sr-sebastian/urubotsrescue/cad/out/masa_cg.md

# Presupuesto de masa y centro de gravedad

_Archivo generado por `cad/build.py`: no editar a mano._

**Masa total estimada: 16.50 kg**  
**CG (base_footprint): x = 29 mm, y = 1 mm, z = 113 mm**

| Código | Pieza | Cant. | g/u | g total |
|---|---|---:|---:|---:|
| REF-M1 | Motorreductor 775 24V planetario 42mm (tracción) | 2 | 750 | 1500 |
| CH-01 | Placa lateral | 2 | 741 | 1482 |
| REF-BAT | Batería 6S Li-ion 21700 6S2P (≈10 Ah) | 1 | 1300 | 1300 |
| — | Bulonería, rodamientos, escuadras | 1 | 1100 | 1100 |
| — | Cableado y conectores | 1 | 900 | 900 |
| CH-03 | Piso | 1 | 777 | 777 |
| REF-M2 | Motorreductor 775 24V planetario 56mm 1:264 (flipper) | 1 | 750 | 750 |
| CH-04 | Deck superior | 1 | 541 | 541 |
| DT-02 | Polea delantera compuesta 60T+60T | 2 | 249 | 498 |
| FL-01 | Brazo de flipper | 2 | 226 | 451 |
| CH-02 | Placa exterior de oruga | 2 | 225 | 451 |
| REF-SV | Servo Feetech STS3215 12 V (x7) | 7 | 55 | 385 |
| REF-S2 | Tubo de flipper Al 6061 20x2 x 400 | 1 | 348 | 348 |
| REF-DEP | Cámara de profundidad (Orbbec Gemini 2 / RealSense D435i) | 1 | 300 | 300 |
| REF-jetson | Jetson Orin Nano Super (devkit) | 1 | 280 | 280 |
| CH-06 | Mamparo trasero (panel de conectores) | 1 | 270 | 270 |
| CH-05 | Mamparo delantero | 1 | 268 | 268 |
| REF-LID | Livox Mid-360 (LiDAR 3D) | 1 | 265 | 265 |
| REF-B1 | Correa HTD 1100-5M-25 (oruga) | 2 | 131 | 262 |
| — | Cámaras USB (x3) + parlante + micrófono | 1 | 250 | 250 |
| CH-07 | Escuadra Al 20x20x2 | 4 | 62 | 246 |
| DT-01 | Polea motriz trasera 60T HTD5M | 2 | 122 | 244 |
| FL-02 | Cubo de flipper | 2 | 115 | 230 |
| REF-B2 | Tacos montados (oruga principal) | 2 | 92 | 184 |
| REF-B3 | Correa HTD 760-5M-25 (flipper) | 2 | 91 | 182 |
| REF-S1 | Eje motriz acero 12 mm (largo según params) | 2 | 83 | 165 |
| DT-03 | Rodillo de apoyo ø40 | 6 | 22 | 130 |
| REF-B4 | Tacos montados (flipper) | 2 | 64 | 128 |
| AR-02 | Torreta + mejillas del hombro | 1 | 122 | 122 |
| REF-buck_12v_pc | Buck 24->12 V 10 A (Jetson) | 1 | 120 | 120 |
| REF-buck_12v_arm | Buck 24->12 V 10 A (servos brazo) | 1 | 120 | 120 |
| REF-drv_traccion | Cytron MDD20A (tracción, 2 canales) | 1 | 120 | 120 |
| REF-hub_usb | Hub USB 3.0 alimentado 7 puertos | 1 | 120 | 120 |
| DT-08 | Soporte motor de tracción (tensable) | 2 | 59 | 118 |
| MT-01 | Bandeja de electrónica | 1 | 115 | 115 |
| AR-04 | Codo inferior + servo J3 | 1 | 110 | 110 |
| REF-rele_estop | Contactor/relé 40 A del E-stop | 1 | 100 | 100 |
| AR-01 | Base del brazo | 1 | 100 | 100 |
| CH-09 | Asa de transporte | 2 | 50 | 99 |
| DT-04 | Polea punta de flipper 36T | 2 | 49 | 98 |
| DT-11 | Soporte motor de flipper | 1 | 88 | 88 |
| REF-ESTOP | E-stop hongo 22 mm NC | 1 | 80 | 80 |
| REF-drv_flipper | Cytron MDD10A (flipper + canal libre) | 1 | 80 | 80 |
| REF-fusibles | Caja fusibles ATO 6 vías | 1 | 80 | 80 |
| MT-04 | Cabezal de sensores frontal | 1 | 73 | 73 |
| CH-08 | Separador placa lateral-exterior | 8 | 9 | 72 |
| MT-03 | Mástil del LiDAR | 1 | 63 | 63 |
| REF-F1 | Eje de punta M10 | 2 | 31 | 62 |
| REF-THM | Cámara térmica USB 256x192 | 1 | 60 | 60 |
| REF-esp32 | ESP32-S3 DevKitC-1 + placa base (PCB-01) | 1 | 60 | 60 |
| MT-02 | Cuna de batería | 1 | 58 | 58 |
| AR-07 | Pinza (dedos engranados) + cámara + Hall | 1 | 56 | 56 |
| DT-07 | Polea 30T eje trasero (HTD5M 15) | 2 | 28 | 56 |
| REF-buck_5v | Buck 24->5 V 5 A (lógica/USB/LEDs) | 1 | 50 | 50 |
| AR-03 | Cubo del hombro (2x GT2 40T) | 1 | 47 | 47 |
| AR-06 | Horquilla de muñeca + servo J5 | 1 | 46 | 46 |
| AR-05b | Soporte servo muñeca J4 | 1 | 37 | 37 |
| AR-05a | Cubo del codo (GT2 40T) | 1 | 30 | 30 |
| DT-10 | Polea 30T tubo de flipper (HTD5M 15) | 1 | 27 | 27 |
| DT-06 | Polea 20T motor de tracción (HTD5M 15) | 2 | 12 | 23 |
| FL-05 | Alojamiento rodamiento 6804 | 2 | 11 | 23 |
| FL-04c | Soporte sensor de ángulo | 1 | 19 | 19 |
| MT-06 | Soporte cámara frontal | 1 | 19 | 19 |
| AR-08 | Tubo eslabón 1 (CF 20x18) | 1 | 16 | 16 |
| AR-09 | Tubo eslabón 2 (CF 20x18) | 1 | 14 | 14 |
| DT-09 | Polea 14T motor de flipper (HTD5M 15) | 1 | 12 | 12 |
| MT-05 | Protección del E-stop | 1 | 10 | 10 |
| FL-04b | Engranaje 40T con imán (AS5600) | 1 | 8 | 8 |
| FL-04a | Engranaje 40T sensor (sobre tubo) | 1 | 6 | 6 |
| CH-10 | Separador de rodillo | 6 | 0 | 2 |

## Estabilidad estática (solo orugas, flippers sin apoyar)

- Ángulo de vuelco hacia atrás subiendo de frente: **56°** (escalera del reglamento: hasta 45°; con flippers apoyados el margen crece).
- Ángulo de vuelco lateral: **51°**.

Si cambiás posiciones de batería/electrónica en `params.py`, volvé a correr el build.
