sr-sebastian/urubotsrescue/docs/img/vista_front.png

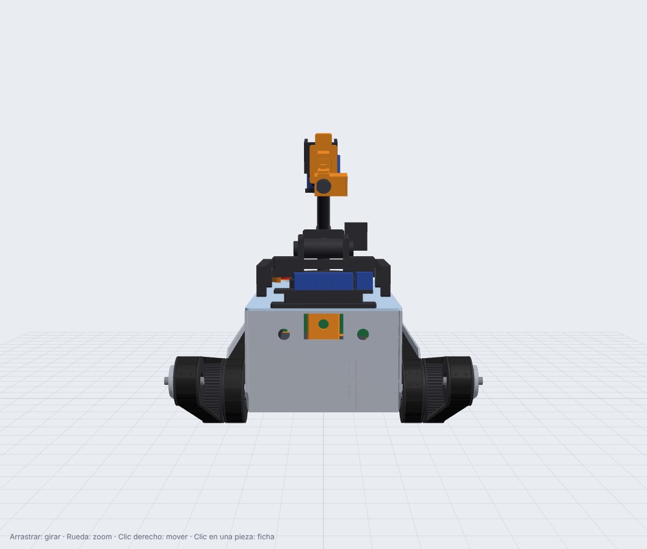
docs/img/vista_front.png
