sr-sebastian/urubotsrescue/docs/img/vista_top.png

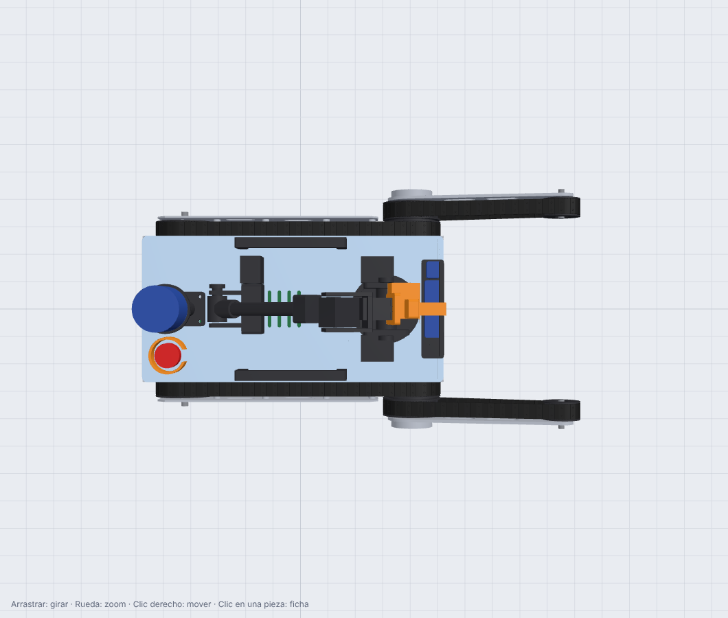
docs/img/vista_top.png
