sr-sebastian/urubotsrescue/hardware/bom.csv

subsistema | item | especificacion | cantidad | usd_unit | proveedor_sugerido | notas
computo | Jetson Orin Nano Super Developer Kit 8GB | JetPack (ver setup-jetson) | 1 | 249 | NVIDIA / distribuidor oficial | ROS 2 Jazzy + YOLO (TensorRT). Revisar al comprar si hay un modelo más nuevo al mismo precio
computo | SSD NVMe M.2 2280 256 GB | PCIe Gen3 | 1 | 30 | local | El sistema va en el NVMe (no en microSD)
computo | ESP32-S3-DevKitC-1 N8R8 | USB nativo | 2 | 15 | Espressif / AliExpress | 1 de repuesto ya flasheado
potencia | Batería 6S2P 21700 (≈10 Ah) con BMS 40 A | 22.2 V nominal / 25.2 V cargada | 3 | 120 | armado local o comercial | 1 en uso + 1 cargando + 1 de reserva
potencia | Cargador balanceador 6S ≥ 200 W | ISDT / ToolkitRC / SkyRC | 1 | 60 | AliExpress | Cargar siempre dentro de bolsa ignífuga
potencia | Bolsa ignífuga para baterías |  | 2 | 10 | AliExpress
potencia | Pulsador de parada de emergencia hongo 22 mm NC | con bloque NC+NO | 1 | 8 | local (electricidad industrial) | Reglamento: E-stop obligatorio
potencia | Relé/contactor DC 24 V 40 A (bobina 24 V) | tipo automotriz 24 V o contactor DC | 1 | 8 | local | El E-stop corta la bobina = corta motores y servos
potencia | Interruptor principal 30 A | rocker o llave rotativa | 1 | 6 | local
potencia | Portafusibles ATO 6 vías + fusibles | 40/20/15/10/5/3 A | 1 | 12 | local (automotriz)
potencia | Shunt 2 mΩ 40 A + módulo INA226 | I2C 0x40 | 1 | 10 | AliExpress
potencia | Convertidor DC-DC 24→12 V 10 A | entrada 9-36 V | 2 | 15 | AliExpress | Uno para Jetson+hub; otro para servos del brazo
potencia | Convertidor DC-DC 24→5 V 5 A |  | 1 | 8 | AliExpress | ESP32 + LEDs + sensores 5 V
potencia | Conectores XT60/XT30 + JST-XH + Dupont + GX12 | kit | 1 | 25 | AliExpress | Ver estándar de conectores en docs/04
potencia | Cable siliconado 12/16/18/22 AWG (rojo/negro) | 2 m de cada | 1 | 25 | AliExpress
motores | Motorreductor 775 24 V planetario 42 mm 1:51 con encoder Hall | ≈118 rpm, ≥4 N·m nominal, eje ≥30 mm | 2 | 45 | AliExpress | Tracción. Verificar PCD 32 mm, M4 y rpm reales del 775
motores | Motorreductor 775 24 V con reductora planetaria 56 mm 1:264 | ≈23 rpm, par nominal de la reductora ≥ 20 N·m, eje 12 mm | 1 | 70 | AliExpress | Flipper (+ correa 14T→30T)
motores | Cytron MDD20A | 2 canales, 20 A, 6-30 V | 1 | 35 | Cytron | Tracción
motores | Cytron MDD10A | 2 canales, 10 A, 5-30 V | 1 | 25 | Cytron | Flipper + canal libre
transmision | Correa HTD 1100-5M-25 | 220 dientes | 4 | 20 | proveedor de transmisiones | 2 + 2 repuesto
transmision | Correa HTD 760-5M-25 | 152 dientes | 4 | 15 | proveedor de transmisiones | 2 + 2 repuesto
transmision | Correa HTD 300-5M-15 | 60 dientes | 3 | 8 |  | tracción izquierda + flipper (+1 rep.)
transmision | Polea HTD 14-5M-15 de aluminio (bore 12 + chavetero) | motor del flipper | 2 | 10 | proveedor de transmisiones | 1 + 1 repuesto
transmision | Correa HTD 425-5M-15 | 85 dientes | 2 | 8 |  | tracción derecha (+1 rep.)
transmision | Rodamiento 6804-2RS (20x32x7) |  | 8 | 3 | local/AliExpress | 2 placas + 4 en poleas delanteras + 2 rep.
transmision | Rodamiento 6900-2RS (10x22x6) |  | 6 | 2 |  | poleas de punta de flipper
transmision | Rodamiento 608-2RS (8x22x7) |  | 12 | 1 |  | 6 rodillos + 4 brazo + 2 rep.
transmision | Rodamiento con brida KFL001 (eje 12) |  | 4 | 4 |  | eje motriz trasero
transmision | Rodamiento MR105-2RS (5x10x4) |  | 2 | 1 |  | sensor de ángulo del flipper
transmision | Eje acero plata 12 mm h7 x 1 m | + chavetas 4x4 | 1 | 15 | local (tornería)
transmision | Tubo Al 6061 20x2 x 1 m | eje de flippers | 1 | 10 | local
transmision | Bulonería (M10x60 8.8 x2; M8x60 x8; M5 y M4 surtido; M3 + insertos térmicos) | kit | 1 | 40 | local
estructura | Corte láser/agua de placas de aluminio | 5052 4 mm (CH-01 x2), 3 mm (CH-02 x2, CH-03, CH-05, CH-06), 6061 5 mm (FL-01 x2) | 1 | 150 | taller de corte local | Enviar DXF de cad/out/dxf
estructura | Policarbonato 4 mm 500x300 | deck CH-04 | 1 | 20 | local | Corte con router o sierra (NO láser CO2)
estructura | Perfil ángulo Al 20x20x2 x 2 m |  | 1 | 10 | local
estructura | Tubo Al 25x2 x 0.3 m | mástil LiDAR | 1 | 5 | local
estructura | Filamento PLA-CF (fibra de carbono) | 1 kg | 2 | 30 |  | poleas y soportes
estructura | Filamento PETG | 1 kg | 2 | 20
estructura | Filamento TPU 95A | 1 kg | 1 | 30 |  | tacos de oruga (≈210)
sensores | Livox Mid-360 | LiDAR 3D 360° + IMU | 1 | 749 | Livox / distribuidor | FAST-LIO y PLY del laberinto
sensores | Cámara de profundidad Orbbec Gemini 2 (o RealSense D435i) | RGB-D | 1 | 234 | Orbbec | Alineada al color para ubicar POIs
sensores | Cámara térmica USB 256x192 (InfiRay P2 Pro / Topdon TC001) | UVC Y16 | 1 | 250 |  | Tarea térmica (5 pts) + firma de calor del laberinto
sensores | Cámara USB 1080p gran angular (ELP o similar) | MJPG | 2 | 35 | AliExpress | frontal + trasera
sensores | Cámara USB mini (endoscopio/módulo 1080p) | para la pinza | 1 | 25 | AliExpress | inspección y QR chicos
sensores | IMU BNO055 (módulo) | I2C 0x28 | 1 | 25 | Adafruit / AliExpress
sensores | Módulo AS5600 + imán diametral | salida analógica | 2 | 4 | AliExpress
sensores | Sensor Hall lineal SS49E |  | 5 | 0.5 | AliExpress | Tarea de proximidad con imán (3 pts)
sensores | Placa de audio USB + micrófono + parlante 3 W |  | 1 | 25 | AliExpress | Audio bidireccional (2 pts)
sensores | Tira WS2812 8 LEDs + 2 focos LED 12 V 3 W + módulo MOSFET |  | 1 | 13 | AliExpress
comunicaciones | Router de viaje 5 GHz con antenas externas (GL.iNet GL-MT3000 o similar) | robot | 1 | 90 |  | Ethernet al Jetson
comunicaciones | Router/AP 5 GHz estación de operador |  | 1 | 90 |  | Mismo SSID dedicado; canal fijo
comunicaciones | Hub USB 3.0 alimentado 7 puertos | entrada 12 V | 1 | 30 |  | Cámaras y adaptadores
comunicaciones | Joystick tipo Xbox con cable |  | 2 | 40 | local | 1 de repuesto
brazo | Servo Feetech STS3215 12 V (30 kg·cm) | bus serie TTL | 8 | 18 | Feetech / AliExpress | 7 + 1 de repuesto
brazo | Adaptador de bus serie Waveshare Bus Servo Adapter (A) | USB | 1 | 8 | Waveshare
brazo | Tubo de fibra de carbono 20x18 x 1 m |  | 1 | 15 | AliExpress | eslabones
brazo | Correas GT2 6 mm cerradas (140 y ≈172 mm) + poleas GT2 20T |  | 1 | 15 | AliExpress
brazo | Rodamiento giratorio "lazy susan" 4 pulgadas |  | 1 | 5 | local
varios | Imanes de neodimio 10x3 + espuma + velcro + precintos + termocontraíble | kit | 1 | 20 | local
varios | Contingencia (≈10%) |  | 1 | 300 |  | repuestos que se rompen en la competencia
