sr-sebastian/urubotsrescue/cad/out/carpincho_ensamble.step

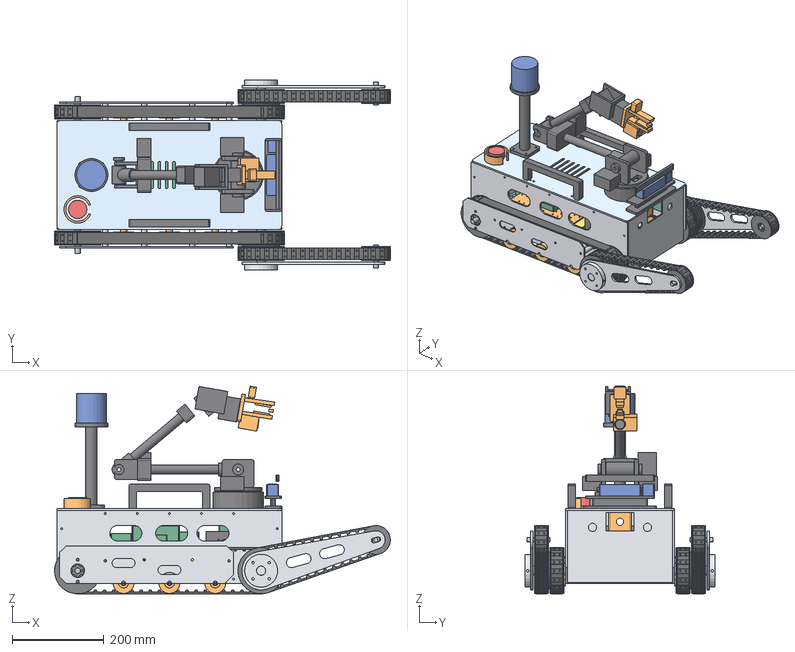
[picture p6: CAD file, 2026-10-31]
cad/out/carpincho_ensamble.step
732.8 x 414.0 x 453.1 mm
CH-01_L
CH-01_R
CH-02_L
CH-02_R
CH-03
CH-04
CH-05
CH-06
CH-07_LB
CH-07_RB
CH-07_LT
CH-07_RT
CH-08_L
CH-08_R
CH-08_L_2
CH-08_R_3
CH-08_L_4
CH-08_R_5
CH-08_L_6
CH-08_R_7
CH-09_0
CH-09_1
CH-10_L
CH-10_R
CH-10_L_2
CH-10_R_3
CH-10_L_4
CH-10_R_5
DT-01_L
DT-01_R
DT-02_L
DT-02_R
DT-03_L
DT-03_R
DT-03_L_2
DT-03_R_3
DT-03_L_4
DT-03_R_5
DT-06_L
DT-06_R
DT-07_L
DT-07_R
DT-08_L
DT-08_R
DT-09
DT-10
DT-11
REF-M1_L
REF-M1_R
REF-M2
REF-B1_L
REF-B1_R
REF-B2_L
REF-B2_R
REF-B3_L
REF-B3_R
REF-B4_L
REF-B4_R
REF-S1_L
REF-S1_R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
