sr-sebastian/urubotsrescue/cad/out/step/DT-08.step

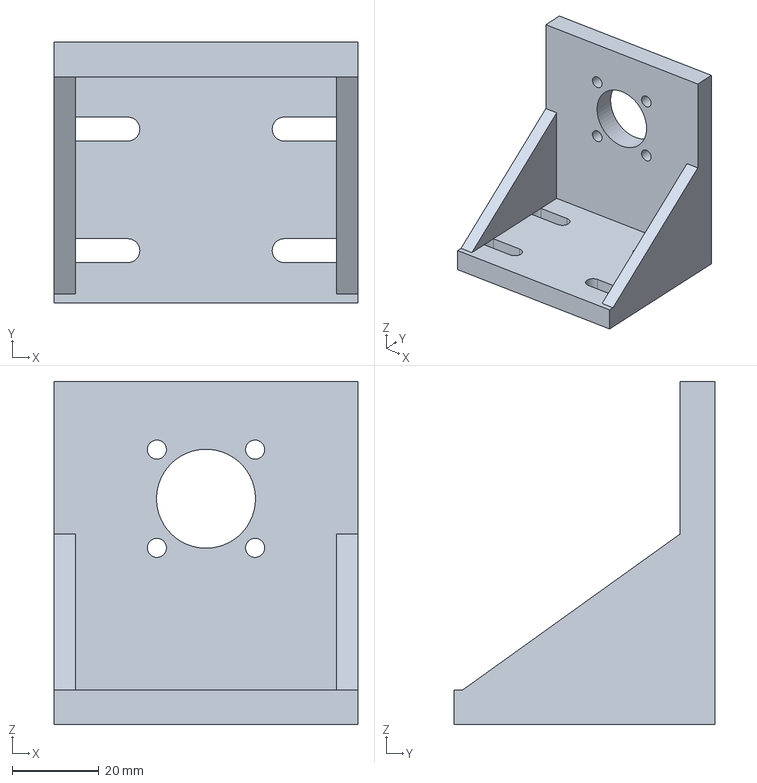
[picture p7: CAD file, 2026-10-31]
cad/out/step/DT-08.step
70.0 x 60.0 x 79.0 mm
