sr-sebastian/urubotsrescue/cad/out/step/MT-05.step

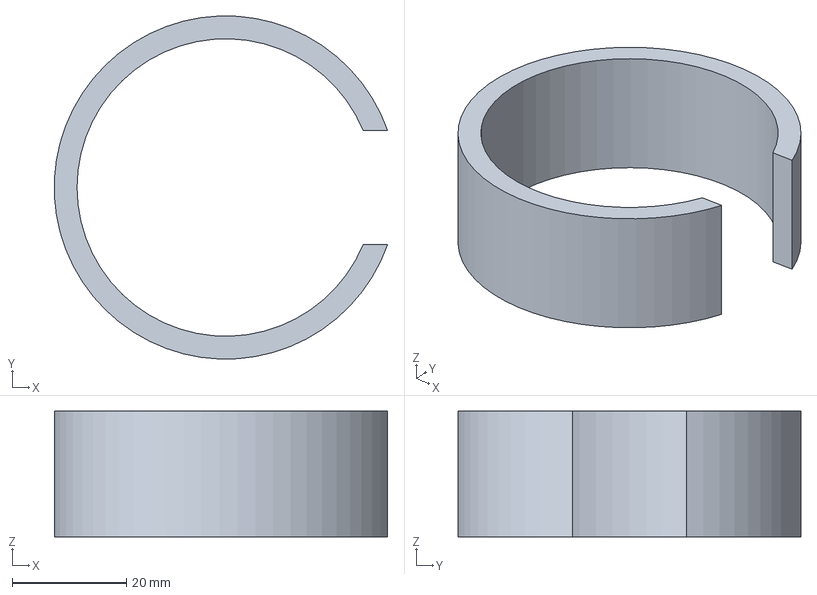
[picture p8: CAD file, 2026-10-31]
cad/out/step/MT-05.step
58.2 x 60.0 x 22.0 mm
