sr-sebastian/urubotsrescue/cad/out/step/FL-04c.step

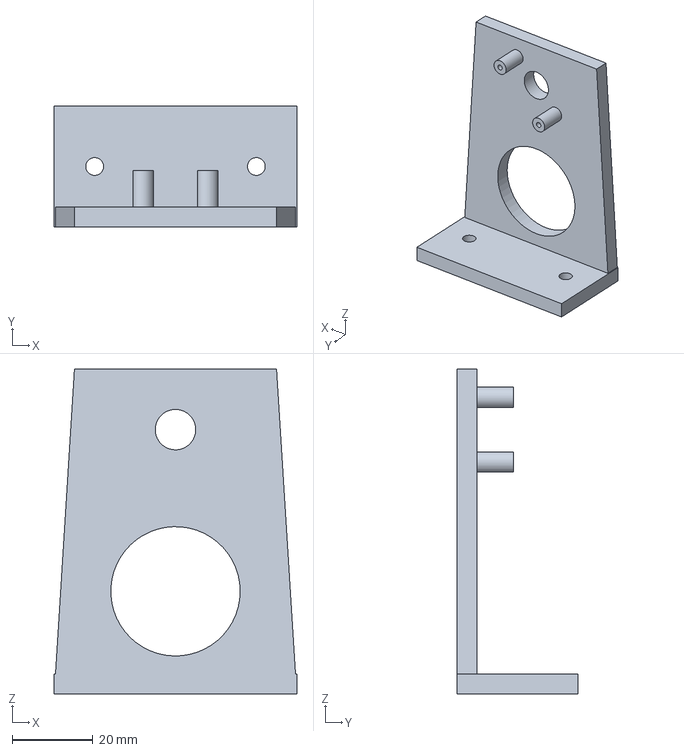
[picture p9: CAD file, 2026-10-31]
cad/out/step/FL-04c.step
60.0 x 30.0 x 80.4 mm
