sr-sebastian/urubotsrescue/cad/out/step/CH-04.step

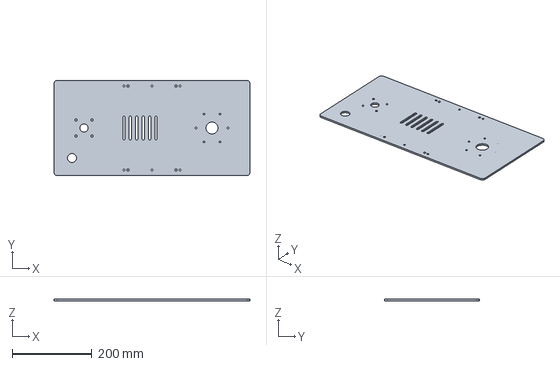
[picture p10: CAD file, 2026-10-31]
cad/out/step/CH-04.step
490.0 x 238.0 x 4.00 mm
