sr-sebastian/urubotsrescue/cad/out/step/DT-01.step

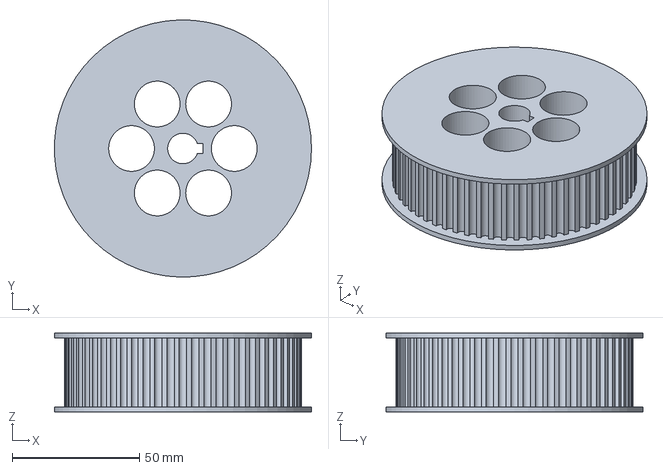
[picture p11: CAD file, 2026-10-31]
cad/out/step/DT-01.step
101.1 x 101.2 x 31.0 mm
