sr-sebastian/urubotsrescue/cad/out/step/DT-11.step

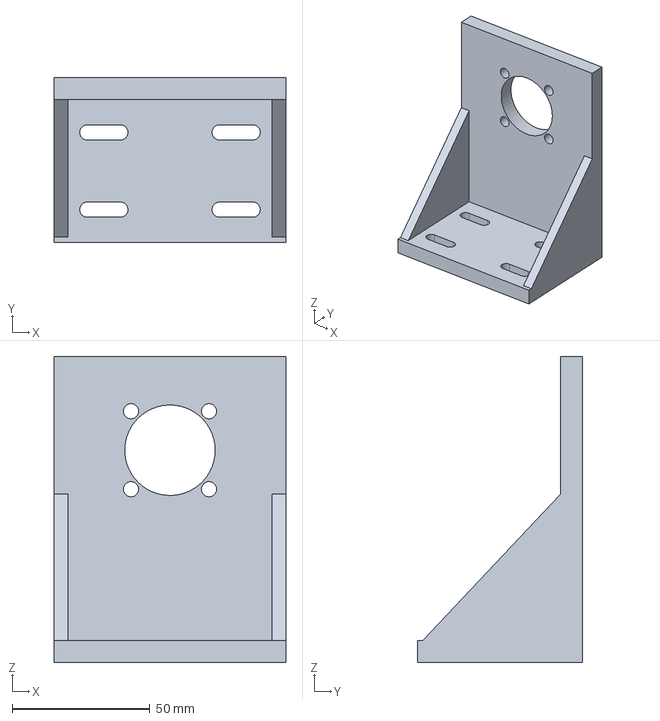
[picture p12: CAD file, 2026-10-31]
cad/out/step/DT-11.step
84.0 x 60.0 x 111.0 mm
