sr-sebastian/urubotsrescue/cad/out/step/FL-04b.step

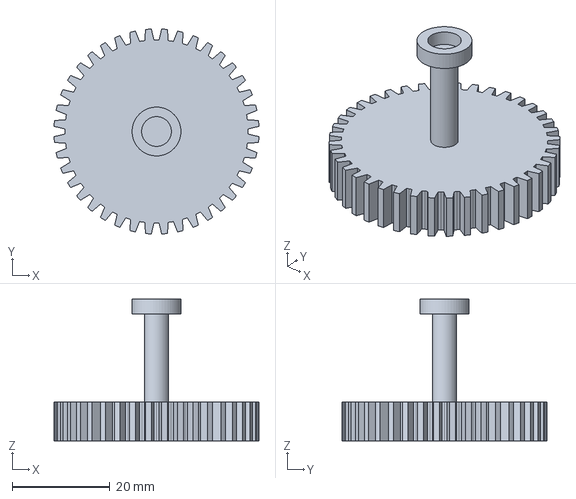
[picture p13: CAD file, 2026-10-31]
cad/out/step/FL-04b.step
41.9 x 41.9 x 29.0 mm
