sr-sebastian/urubotsrescue/cad/out/step/CH-09.step

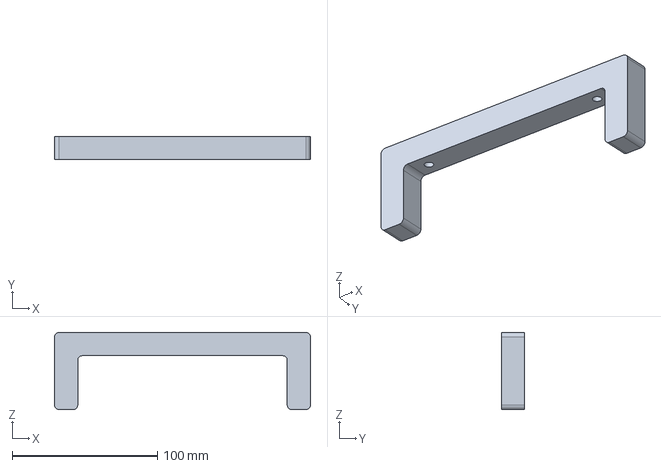
[picture p14: CAD file, 2026-10-31]
cad/out/step/CH-09.step
176.0 x 16.0 x 53.0 mm
