sr-sebastian/urubotsrescue/cad/out/step/CH-01.step

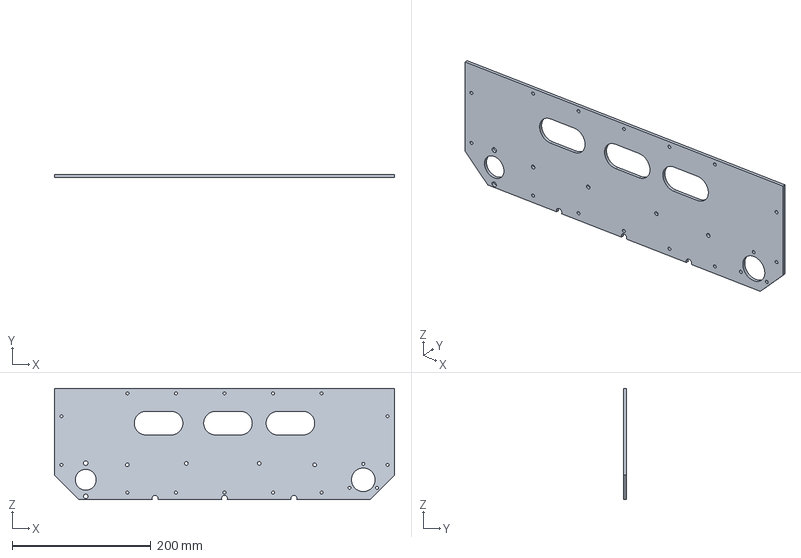
[picture p15: CAD file, 2026-10-31]
cad/out/step/CH-01.step
490.0 x 4.00 x 160.0 mm
