sr-sebastian/urubotsrescue/cad/out/step/DT-05.step

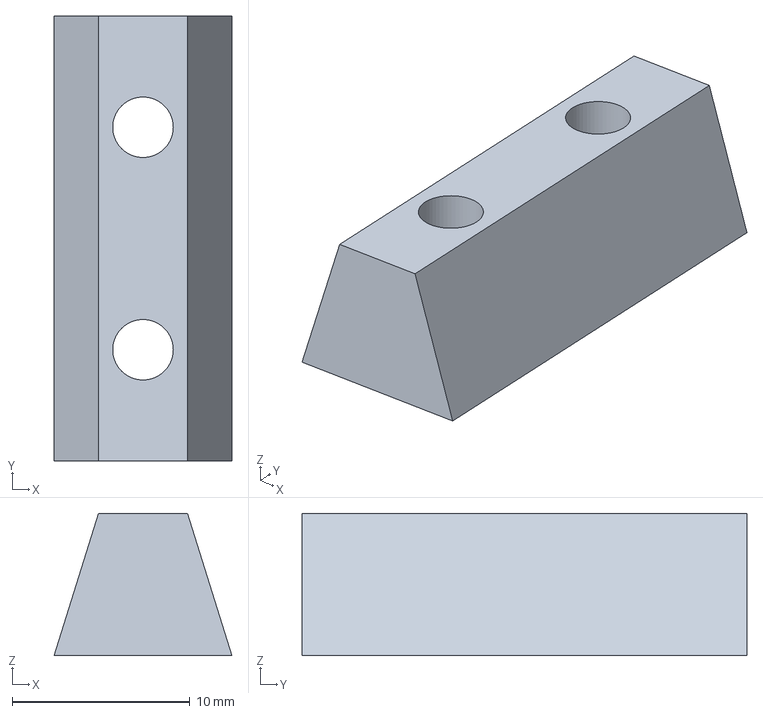
[picture p16: CAD file, 2026-10-31]
cad/out/step/DT-05.step
10.0 x 25.0 x 8.00 mm
