sr-sebastian/urubotsrescue/cad/out/step/DT-09.step

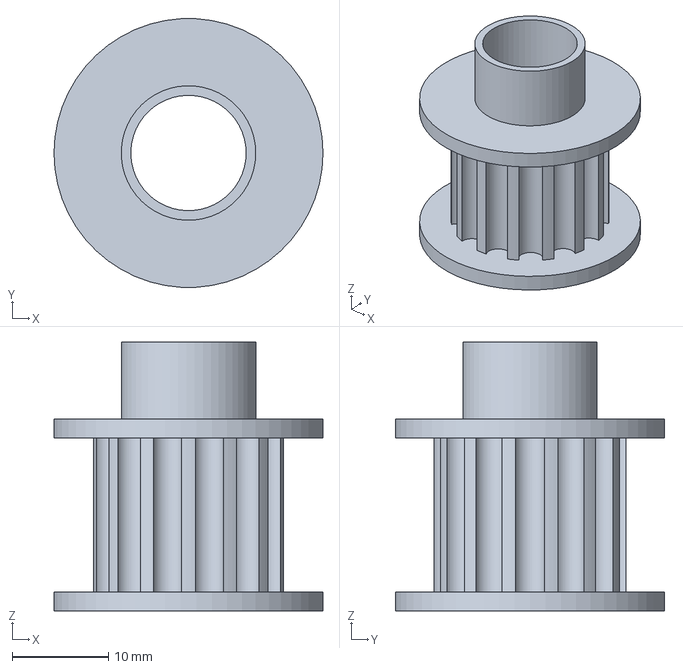
[picture p17: CAD file, 2026-10-31]
cad/out/step/DT-09.step
28.0 x 28.0 x 28.0 mm
