sr-sebastian/urubotsrescue/cad/out/step/MT-06.step

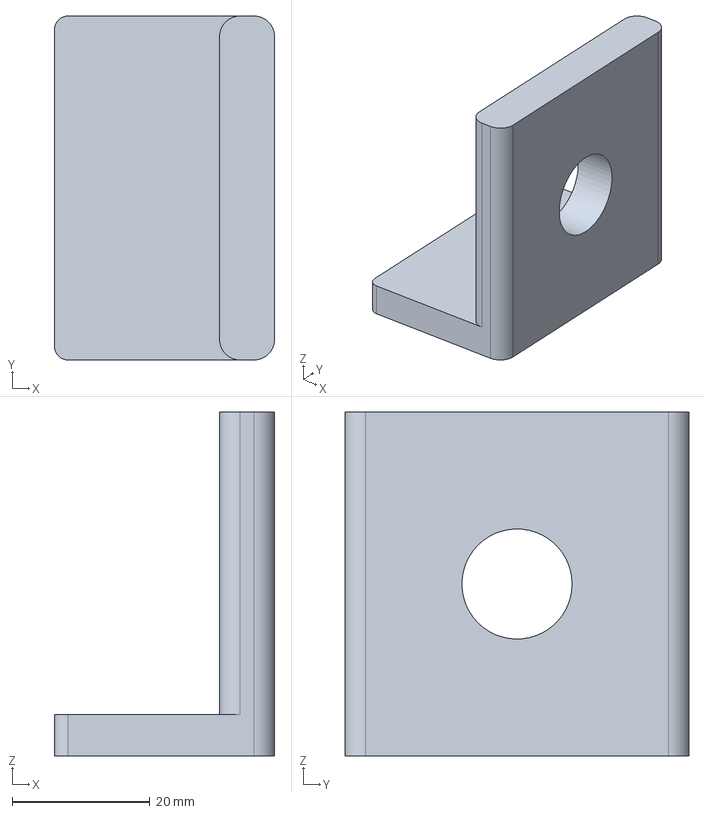
[picture p18: CAD file, 2026-10-31]
cad/out/step/MT-06.step
32.0 x 50.0 x 50.0 mm
