sr-sebastian/urubotsrescue/cad/out/step/AR-02.step

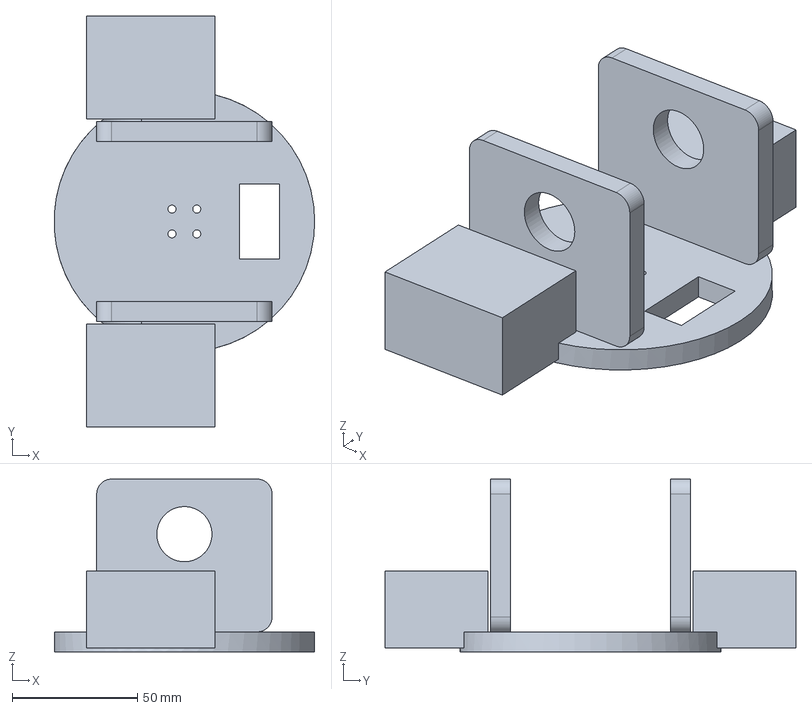
[picture p19: CAD file, 2026-10-31]
cad/out/step/AR-02.step
103.9 x 164.0 x 69.0 mm
