sr-sebastian/urubotsrescue/cad/out/step/MT-03.step

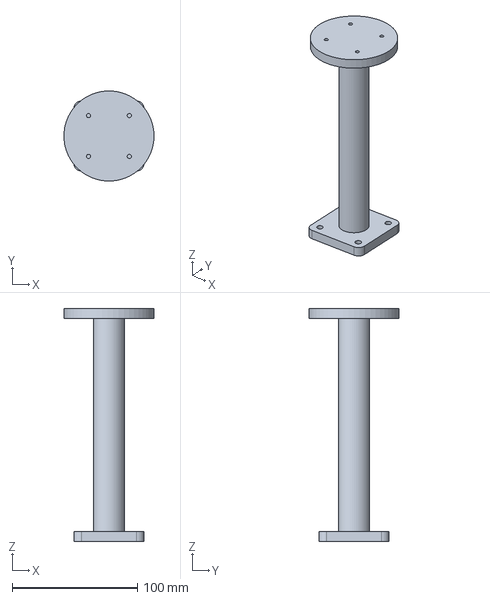
[picture p20: CAD file, 2026-10-31]
cad/out/step/MT-03.step
71.9 x 72.0 x 186.0 mm
