sr-sebastian/urubotsrescue/cad/out/step/AR-04.step

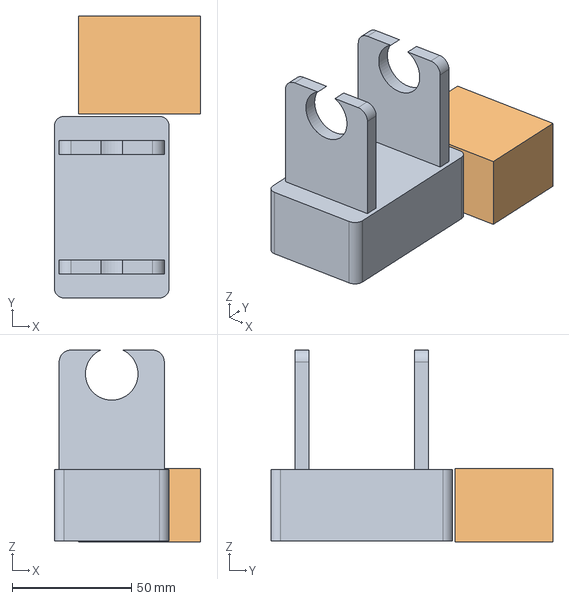
[picture p21: CAD file, 2026-10-31]
cad/out/step/AR-04.step
61.2 x 118.0 x 80.4 mm
