sr-sebastian/urubotsrescue/cad/out/step/CH-06.step

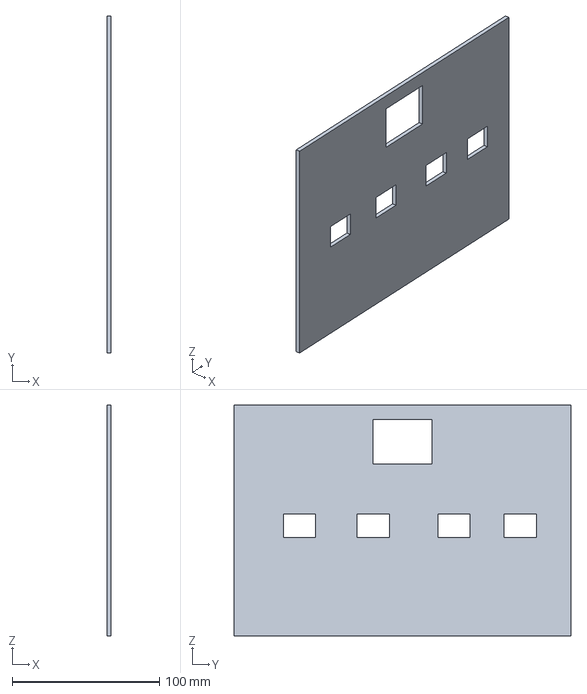
[picture p22: CAD file, 2026-10-31]
cad/out/step/CH-06.step
3.00 x 229.0 x 157.0 mm
