sr-sebastian/urubotsrescue/cad/out/step/CH-08.step

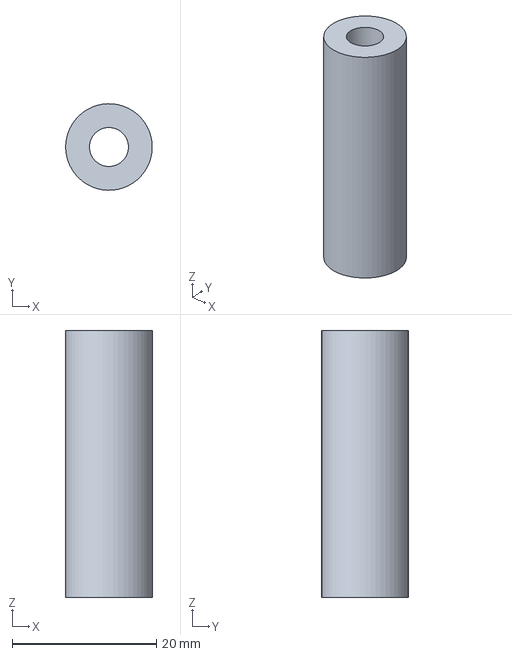
[picture p23: CAD file, 2026-10-31]
cad/out/step/CH-08.step
12.0 x 12.0 x 37.0 mm
