sr-sebastian/urubotsrescue/cad/out/step/CH-05.step

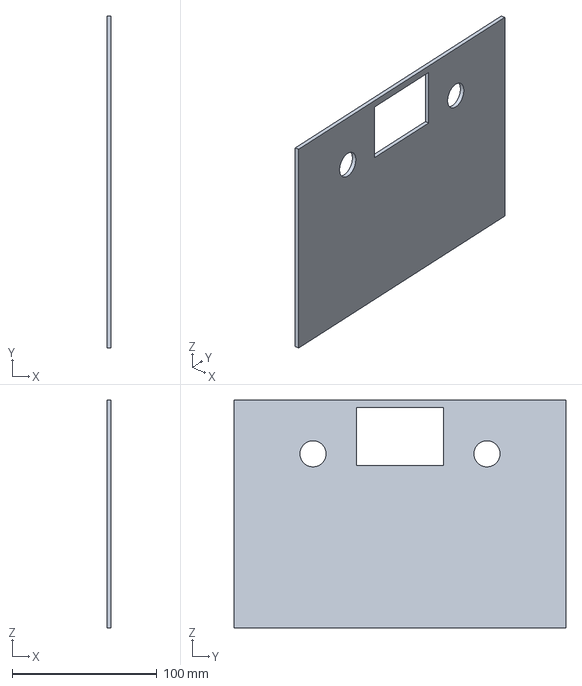
[picture p24: CAD file, 2026-10-31]
cad/out/step/CH-05.step
3.00 x 229.0 x 157.0 mm
