sr-sebastian/urubotsrescue/cad/out/step/DT-02.step

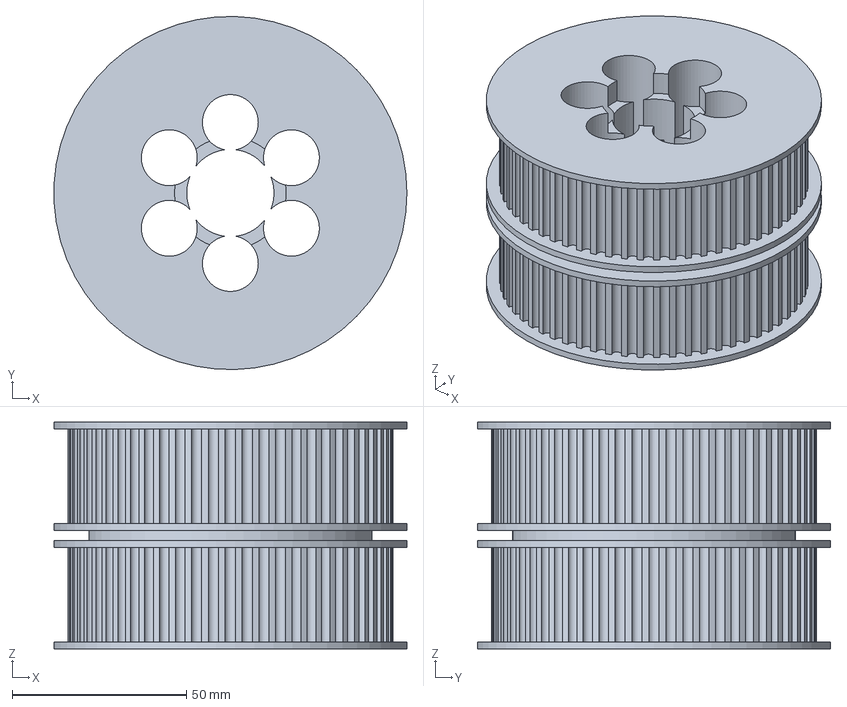
[picture p25: CAD file, 2026-10-31]
cad/out/step/DT-02.step
101.1 x 101.2 x 65.0 mm
