sr-sebastian/urubotsrescue/cad/out/step/CH-03.step

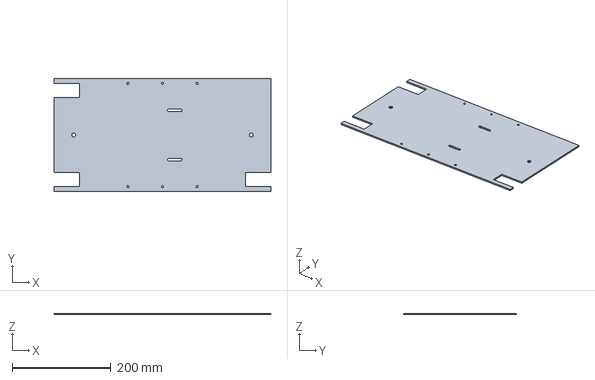
[picture p26: CAD file, 2026-10-31]
cad/out/step/CH-03.step
440.0 x 229.0 x 3.00 mm
