sr-sebastian/urubotsrescue/cad/out/step/DT-04.step

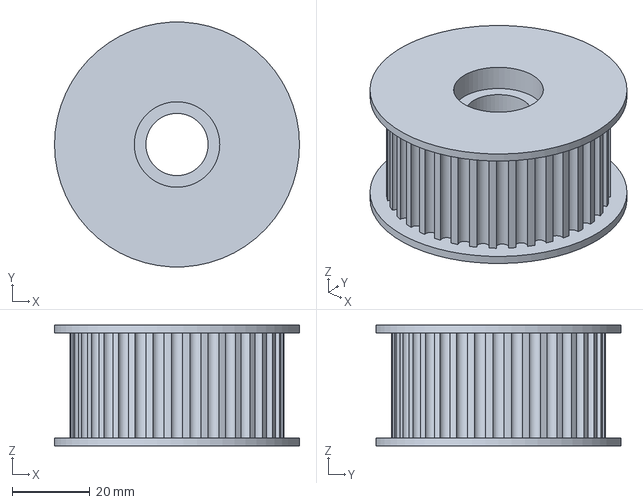
[picture p27: CAD file, 2026-10-31]
cad/out/step/DT-04.step
63.0 x 62.9 x 31.0 mm
