sr-sebastian/urubotsrescue/cad/out/step/AR-05a.step

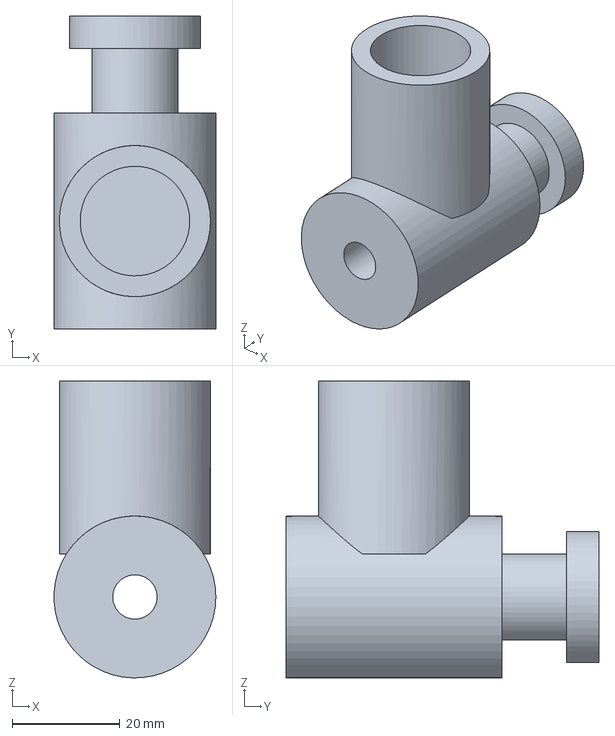
[picture p28: CAD file, 2026-10-31]
cad/out/step/AR-05a.step
30.0 x 58.0 x 55.0 mm
