sr-sebastian/urubotsrescue/cad/out/step/AR-07.step

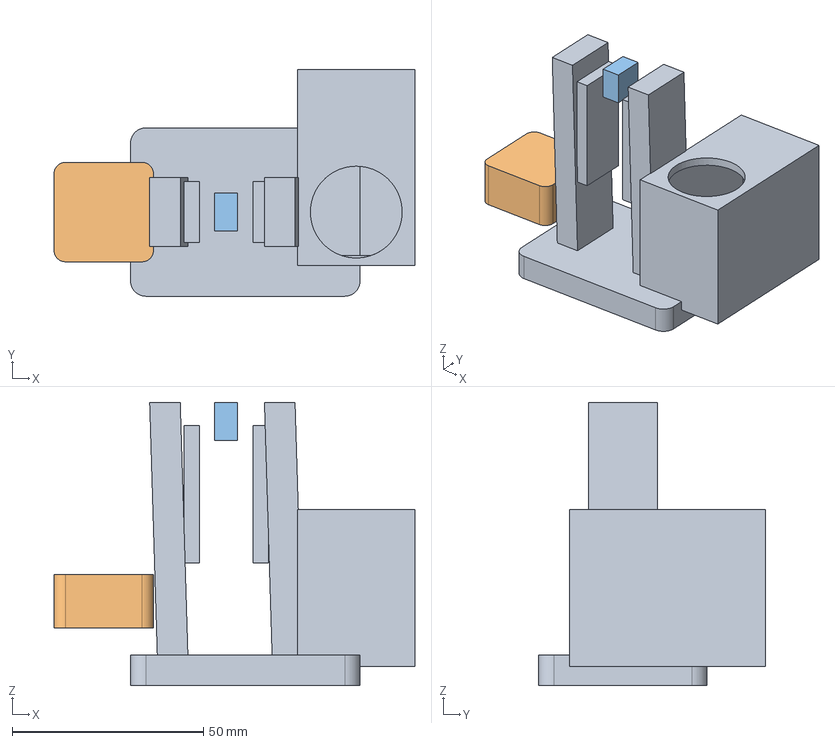
[picture p29: CAD file, 2026-10-31]
cad/out/step/AR-07.step
94.3 x 59.2 x 74.0 mm
