sr-sebastian/urubotsrescue/cad/out/step/DT-10.step

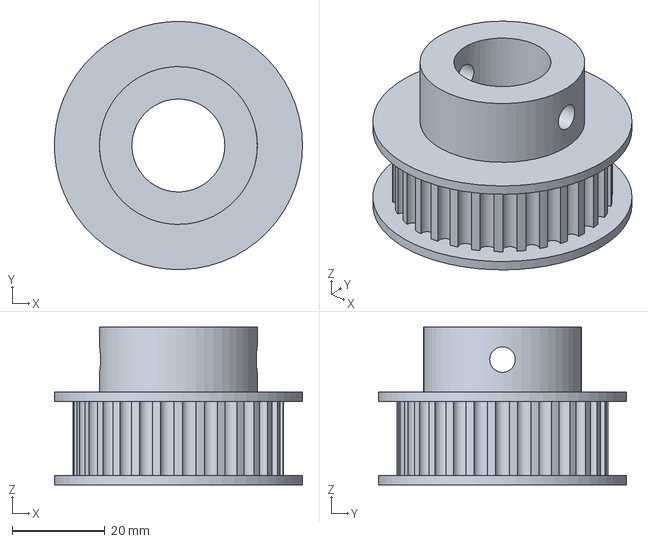
[picture p30: CAD file, 2026-10-31]
cad/out/step/DT-10.step
53.4 x 53.4 x 34.0 mm
