sr-sebastian/urubotsrescue/cad/out/step/AR-03.step

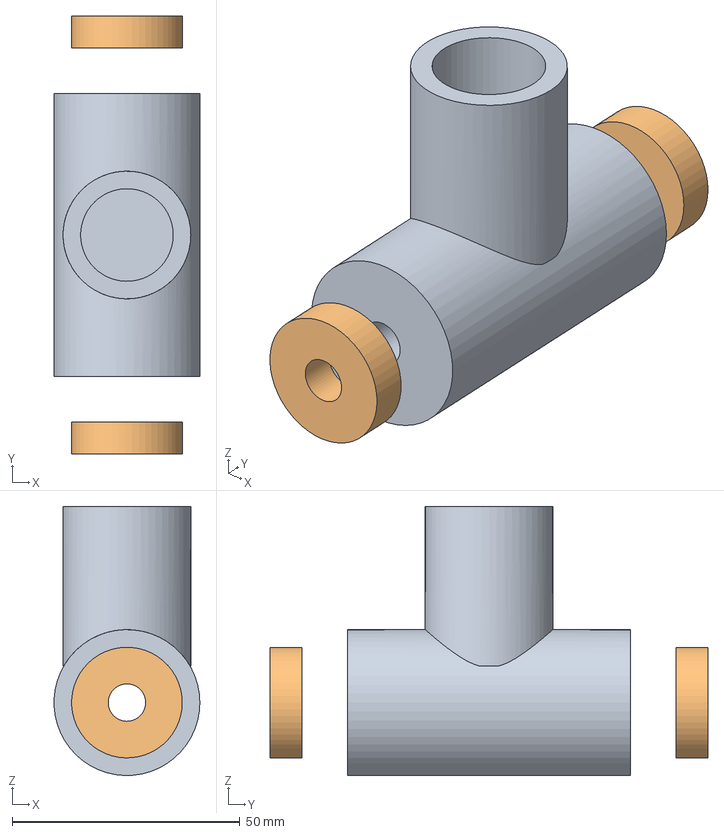
[picture p31: CAD file, 2026-10-31]
cad/out/step/AR-03.step
32.0 x 96.0 x 59.0 mm
