sr-sebastian/urubotsrescue/cad/out/step/AR-05b.step

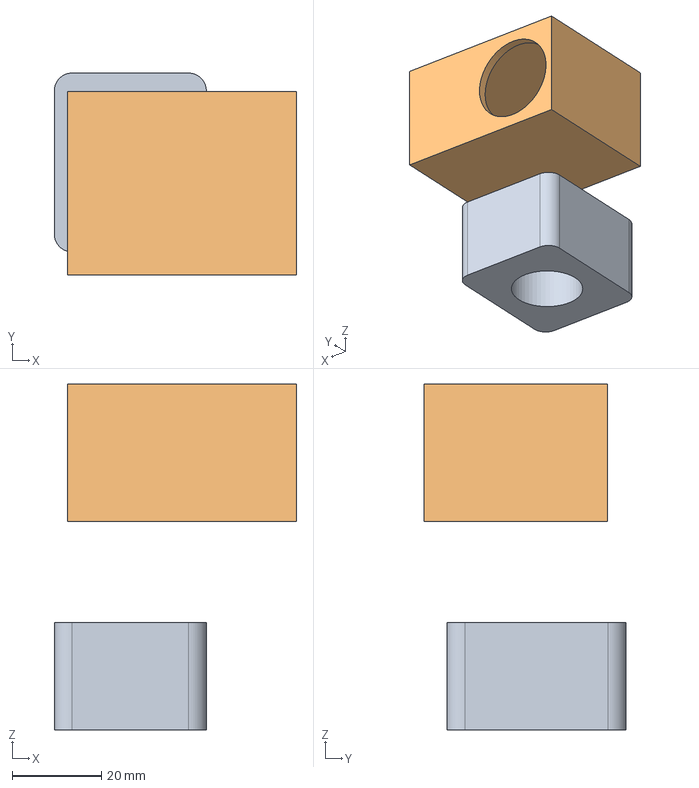
[picture p32: CAD file, 2026-10-31]
cad/out/step/AR-05b.step
54.2 x 45.1 x 77.4 mm
