sr-sebastian/urubotsrescue/cad/out/step/CH-10.step

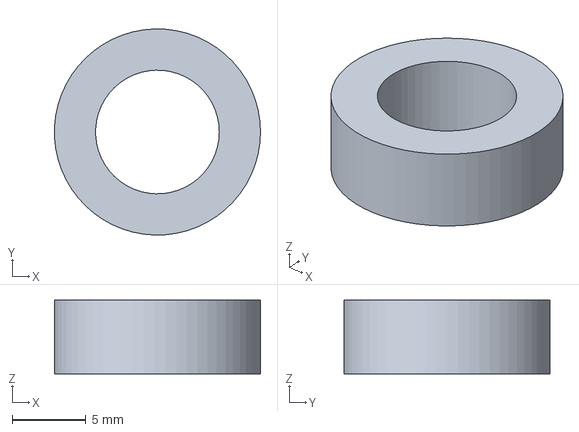
[picture p33: CAD file, 2026-10-31]
cad/out/step/CH-10.step
14.0 x 14.0 x 5.00 mm
