sr-sebastian/urubotsrescue/cad/out/step/FL-02.step

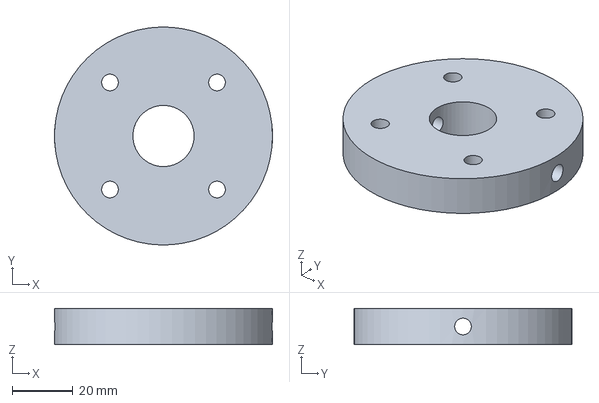
[picture p34: CAD file, 2026-10-31]
cad/out/step/FL-02.step
72.0 x 72.0 x 12.0 mm
