sr-sebastian/urubotsrescue/cad/out/step/MT-02.step

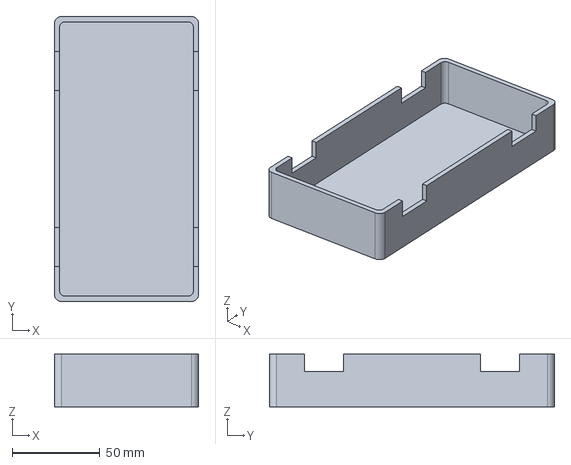
[picture p35: CAD file, 2026-10-31]
cad/out/step/MT-02.step
82.0 x 162.0 x 30.0 mm
