sr-sebastian/urubotsrescue/cad/out/step/FL-05.step

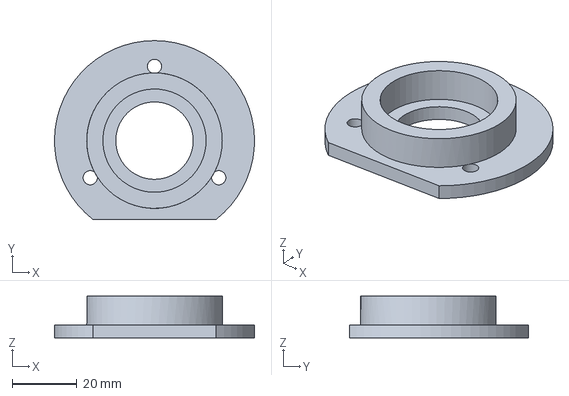
[picture p36: CAD file, 2026-10-31]
cad/out/step/FL-05.step
62.0 x 55.4 x 13.0 mm
