sr-sebastian/urubotsrescue/cad/out/step/MT-04.step

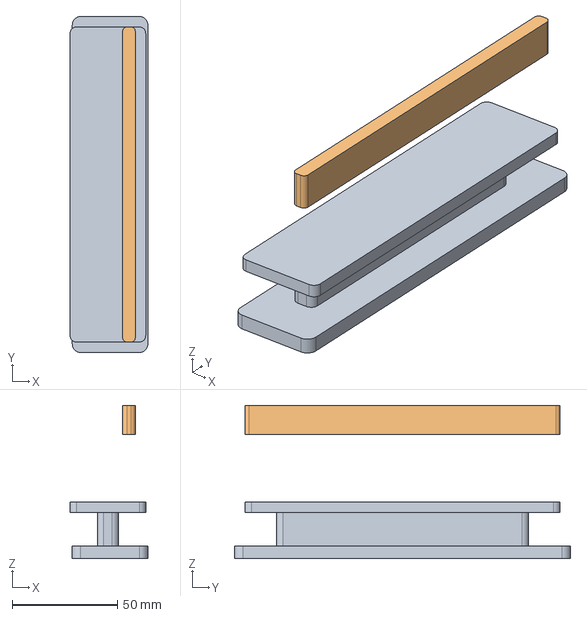
[picture p37: CAD file, 2026-10-31]
cad/out/step/MT-04.step
37.0 x 160.0 x 73.0 mm
