sr-sebastian/urubotsrescue/cad/out/step/MT-01.step

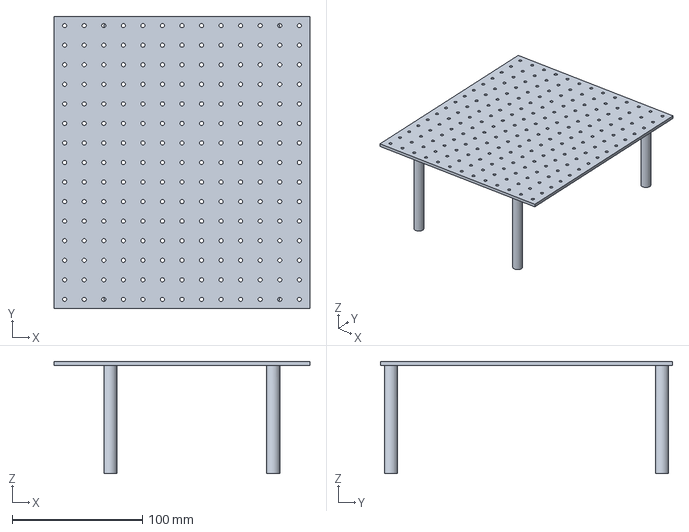
[picture p38: CAD file, 2026-10-31]
cad/out/step/MT-01.step
196.0 x 224.0 x 86.0 mm
