sr-sebastian/urubotsrescue/cad/out/step/AR-01.step

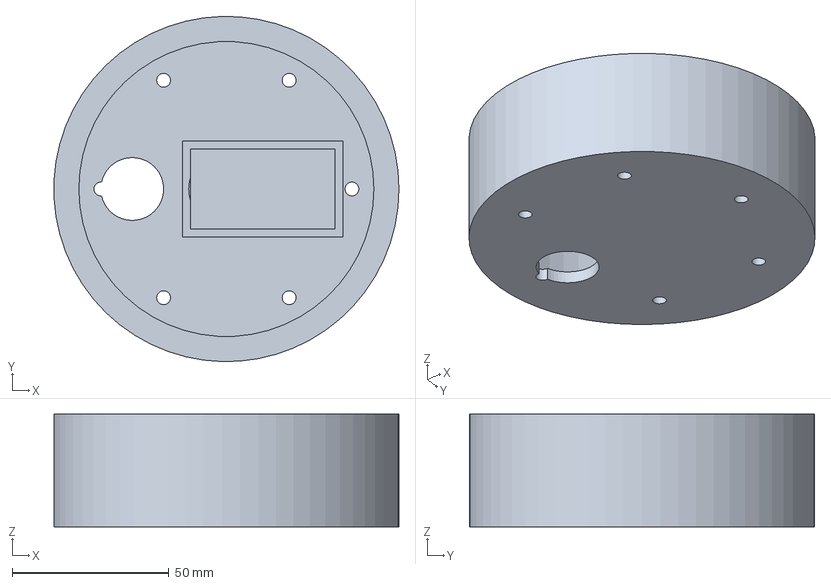
[picture p39: CAD file, 2026-10-31]
cad/out/step/AR-01.step
109.9 x 110.0 x 36.0 mm
