sr-sebastian/urubotsrescue/cad/out/step/DT-06.step

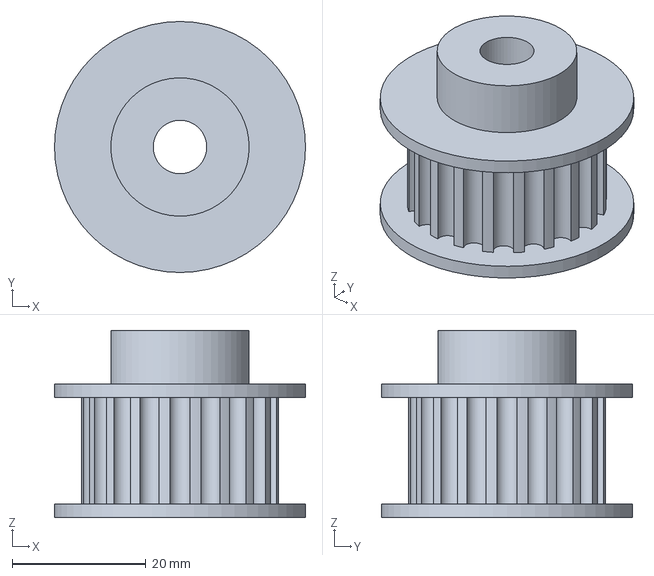
[picture p40: CAD file, 2026-10-31]
cad/out/step/DT-06.step
37.6 x 37.6 x 28.0 mm
