sr-sebastian/urubotsrescue/cad/out/step/FL-01.step

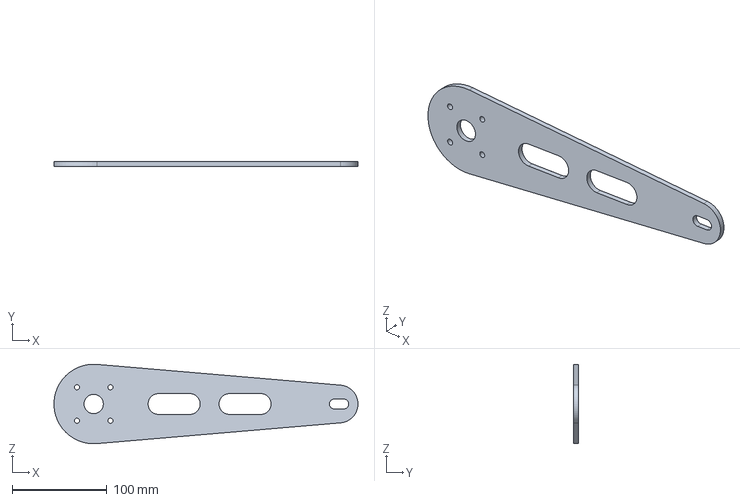
[picture p41: CAD file, 2026-10-31]
cad/out/step/FL-01.step
321.2 x 5.00 x 83.9 mm
