sr-sebastian/urubotsrescue/cad/out/step/CH-02.step

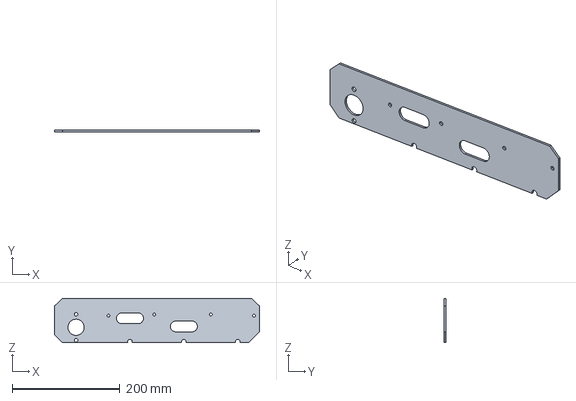
[picture p42: CAD file, 2026-10-31]
cad/out/step/CH-02.step
380.3 x 3.00 x 82.0 mm
