sr-sebastian/urubotsrescue/cad/out/step/AR-06.step

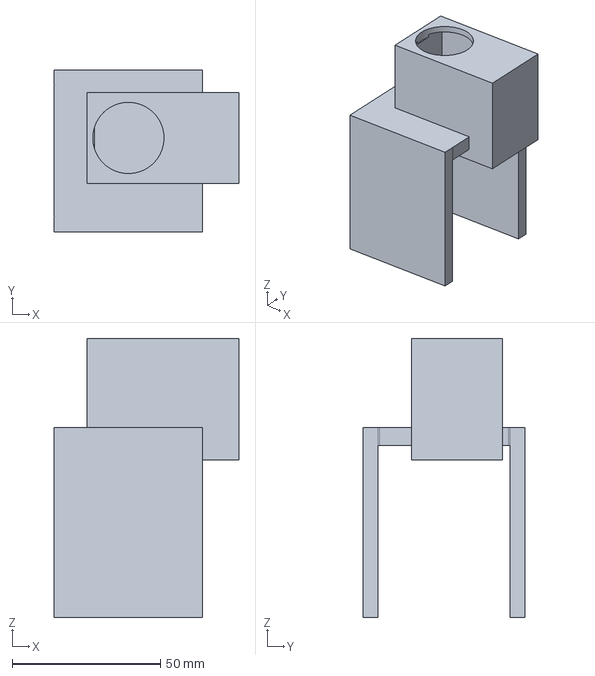
[picture p43: CAD file, 2026-10-31]
cad/out/step/AR-06.step
62.2 x 54.5 x 94.0 mm
