sr-sebastian/urubotsrescue/cad/out/step/DT-07.step

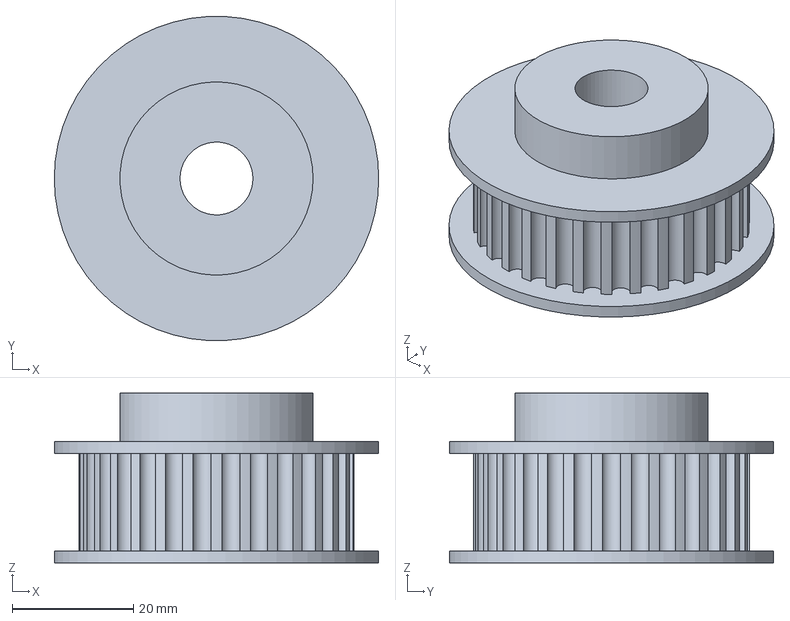
[picture p44: CAD file, 2026-10-31]
cad/out/step/DT-07.step
53.5 x 53.4 x 28.0 mm
