sr-sebastian/urubotsrescue/cad/out/step/FL-04a.step

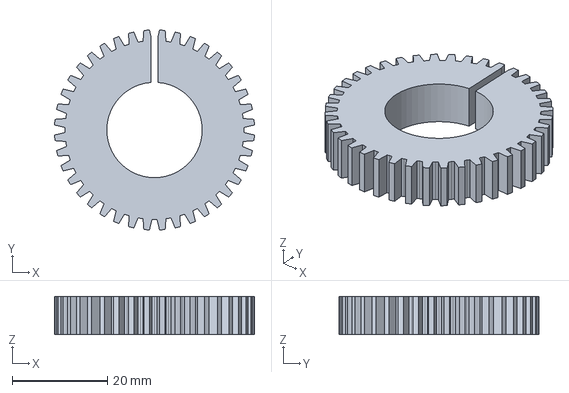
[picture p45: CAD file, 2026-10-31]
cad/out/step/FL-04a.step
41.9 x 41.9 x 8.00 mm
