sr-sebastian/urubotsrescue/cad/out/step/DT-03.step

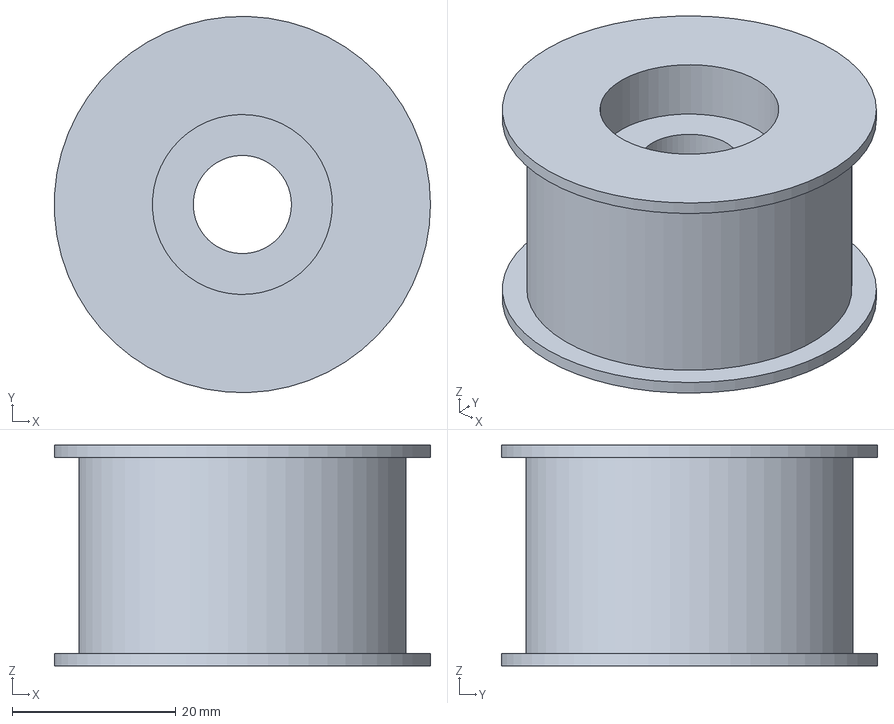
[picture p46: CAD file, 2026-10-31]
cad/out/step/DT-03.step
46.0 x 46.0 x 27.0 mm
