sr-sebastian/urubotsrescue/(list of files, cad)

Other CAD files:
cad/out/dxf/CH-01.dxf
cad/out/dxf/CH-02.dxf
cad/out/dxf/CH-03.dxf
cad/out/dxf/CH-04.dxf
cad/out/dxf/CH-05.dxf
cad/out/dxf/CH-06.dxf
cad/out/dxf/FL-01.dxf
cad/out/stl/AR-01.stl
cad/out/stl/AR-02.stl
cad/out/stl/AR-03.stl
cad/out/stl/AR-04.stl
cad/out/stl/AR-05a.stl
cad/out/stl/AR-05b.stl
cad/out/stl/AR-06.stl
cad/out/stl/AR-07.stl
cad/out/stl/CH-01.stl
cad/out/stl/CH-02.stl
cad/out/stl/CH-03.stl
cad/out/stl/CH-04.stl
cad/out/stl/CH-05.stl
cad/out/stl/CH-06.stl
cad/out/stl/CH-08.stl
cad/out/stl/CH-09.stl
cad/out/stl/CH-10.stl
cad/out/stl/DT-01.stl
cad/out/stl/DT-02.stl
cad/out/stl/DT-03.stl
cad/out/stl/DT-04.stl
cad/out/stl/DT-05.stl
cad/out/stl/DT-06.stl
cad/out/stl/DT-07.stl
cad/out/stl/DT-08.stl
cad/out/stl/DT-09.stl
cad/out/stl/DT-10.stl
cad/out/stl/DT-11.stl
cad/out/stl/FL-01.stl
cad/out/stl/FL-02.stl
cad/out/stl/FL-04a.stl
cad/out/stl/FL-04b.stl
cad/out/stl/FL-04c.stl
cad/out/stl/FL-05.stl
cad/out/stl/MT-01.stl
cad/out/stl/MT-02.stl
cad/out/stl/MT-03.stl
cad/out/stl/MT-04.stl
cad/out/stl/MT-05.stl
cad/out/stl/MT-06.stl
