sr-sebastian/urubotsrescue/docs/07-pruebas/arena-de-pruebas.md

# Arena de pruebas casera

Hace falta practicar con obstáculos del **mismo tamaño** que los del reglamento. Todo se arma con madera de
pino y placas de OSB/fenólico de 18 mm, con módulos de **1.2 × 1.2 m** (como los del reglamento), para poder
reacomodarlos.

| Módulo | Construcción | Materiales aprox. |
|---|---|---|
| Carril (paredes) | 2 paredes de 1.2 m de alto y 2.4 m de largo, separadas 1.2 m; zonas de inicio y fin de 1.2 × 1.2 marcadas con cinta | 4 placas de OSB + listones |
| Rampa 15° y 30° | Placas de 1.2 × 0.6 m sobre caballetes con el ángulo cortado; en "cruzadas", alternar la inclinación | 2 placas fenólicas |
| K-rails | Listones de 10 cm (y 20 cm) con caras a 45°, cruzados en diagonal | tirante 2"×4" |
| Stepfield cúbico | Bloques de 15 × 15 cm de 0, 15 y 30 cm de alto en damero | cajones de OSB |
| Pallets + caños | Pallets estándar con caños de PVC de 100 mm atornillados; escalón de 20 cm | 3 pallets |
| **Escalera 45°** | 4 escalones: contrahuella 20 cm, huella 20 cm, ancho 1.0 m, con nariz recta; descanso de 1.2 m arriba | fenólico de 18 mm + tirantes |
| Grava | Cajón de 1.2 × 2.4 m con 5 cm de piedra partida, inclinable a 15° | 1 m³ de piedra |
| Puerta | Marco de 90 cm con hoja liviana, picaporte a 1.0 m y cierre con resorte | puerta usada |
| Laberinto | Paredes de 1.2 m de alto, pasillos de 1.2 m, reconfigurable; AprilTags 41h12, hazmat, objetos | placas + bisagras |
| Tareas de destreza | Tablero lineal a 60 cm con 5 "tubos" de inspección (QR adentro) y agujeros de 25 mm; omni en un cubo girable | caños de PVC de 75 mm + impresiones |
| Cajón de víctimas | Caja de 40 × 40 × 40 cm con: anillos C sobre un calentador de manos, hazmat, disco giratorio (motor de microondas), QR, imán y parlante con MP3 | |

## Prioridad de construcción

1. **Escalera de 45°** (el obstáculo más exigente y el que define el diseño).
2. Carril con paredes + rampas (para desarrollar `lane_traverse`).
3. Cajón de víctimas (20 puntos con pocos riesgos).
4. Tablero de destreza lineal.
5. Laberinto (para mapeo y POIs).

## Material para imprimir

- Set de etiquetas hazmat oficiales (tamaño real) y versiones parcialmente tapadas.
- QR de distintos tamaños (1, 2, 4 y 8 cm) con textos al azar.
- AprilTags `tagStandard41h12`: generar con la herramienta oficial de AprilTag e imprimir en mate (el brillo
  complica la detección).
- Anillos C concéntricos (Landolt) para la térmica: imprimir en 3D en PLA negro y montar sobre un calentador de manos.

## Seguridad en la arena

- Calzado cerrado y pantalón largo (también lo pide el reglamento).
- Una persona con la mano en el E-stop en cada prueba nueva (en la escalera, **siempre**).
- Colchoneta o espuma al pie de la escalera.
