sr-sebastian/urubotsrescue/ros2_ws/src/carpincho_bringup/config/fast_lio_mid360.yaml

# FAST-LIO (ROS 2, fork hku-mars/FAST_LIO rama ROS2) para Livox Mid-360.
# Extrínsecos: el IMU interno del Mid-360 está a (-0.011, -0.02329, 0.04412) m del origen del LiDAR.
/**:
  ros__parameters:
    feature_extract_enable: false
    point_filter_num: 3
    max_iteration: 3
    filter_size_surf: 0.25
    filter_size_map: 0.25
    cube_side_length: 1000.0
    runtime_pos_log_enable: false
    map_file_path: "./map.pcd"
    common:
      lid_topic: "/livox/lidar"
      imu_topic: "/livox/imu"
      time_sync_en: false
      time_offset_lidar_to_imu: 0.0
    preprocess:
      lidar_type: 1                  # 1 = Livox (CustomMsg). En el driver: xfer_format = 1
      scan_line: 4
      blind: 0.30                    # descarta puntos del propio robot (brazo/mástil)
      timestamp_unit: 3
      scan_rate: 10
    mapping:
      acc_cov: 0.1
      gyr_cov: 0.1
      b_acc_cov: 0.0001
      b_gyr_cov: 0.0001
      fov_degree: 360.0
      det_range: 40.0
      extrinsic_est_en: false
      extrinsic_T: [-0.011, -0.02329, 0.04412]
      extrinsic_R: [1.0, 0.0, 0.0, 0.0, 1.0, 0.0, 0.0, 0.0, 1.0]
    publish:
      path_en: true
      effect_map_en: false
      map_en: true                   # /Laser_map -> PLY del laberinto
      scan_publish_en: true
      dense_publish_en: true
      scan_bodyframe_pub_en: true    # /cloud_registered_body -> /scan (pointcloud_to_laserscan)
    pcd_save:
      pcd_save_en: true
      interval: -1
