sr-sebastian/urubotsrescue/(commit log)

2026-10-31 Carpincho URB-R1: CAD paramétrico, firmware ESP32-S3 y stack ROS 2
    - cad/: piezas paramétricas en CadQuery (chasis, orugas HTD5M, flippers, brazo C1, soportes)
    con exportación STEP/STL/DXF, ensamble GLB, masa y centro de gravedad
    - visor/: visor 3D web (three.js) con despiece y fichas de piezas
    - firmware/: placa base ESP32-S3 (PI de orugas, flipper con AS5600, IMU, INA226, watchdog)
    con protocolo COBS+CRC y tests de PC
    - ros2_ws/: interfaces, descripción URDF, puente serie, brazo STS3215, teleop,
    percepción (QR, hazmat, movimiento, térmica, POIs, exportación RRL), autonomía de carril
    - tools/: simulador de placa base y capturas del visor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
    [AR-01.step, AR-01.stl, AR-02.step, AR-02.stl, AR-03.step, AR-03.stl, AR-04.step, AR-04.stl]
2026-10-31 Megaproyecto completo: documentación, BOM, herramientas y correcciones de diseño
    - docs/: plan maestro (cronograma, roles, presupuesto, riesgos), reglamento RRL 2026 y estrategia,
    arquitectura (ICD, grafo ROS, TF, seguridad), diseño mecánico, electrónica y cableado,
    software (Jetson, firmware, ROS 2, percepción, mapeo/autonomía, comunicaciones, calibración),
    guía de armado, plan de pruebas, arena casera, checklists de competencia y solución de errores
    - hardware/: BOM con costos (≈3900 USD) y alternativas de bajo costo
    - tools/: simulador de la placa base, herramienta de servos, generador de docs,
    chequeo automático de interferencias (también en CI)
    - operator/: layout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
    [AR-01.step, AR-01.stl, AR-02.step, AR-02.stl, AR-03.step, AR-03.stl, AR-04.step, AR-04.stl]
2026-10-31 Enfoque 2027: ROS 2 Jazzy, sin depender de hardware ni código previos del equipo
    - ROS 2 Jazzy como objetivo (Humble termina su soporte en mayo de 2027, antes de la competencia):
    instalación nativa (Ubuntu 24.04) o en Docker sobre JetPack 6, servicio systemd actualizado
    - Plan, BOM y backlog ya no asumen hardware viejo del equipo (Jetson Nano, LIMO, LiDAR 2D):
    planes B con compras de menor costo y desarrollo con fake_base + CI
    - Reglamento: objetivo 2027, base 2026D hasta que salga el nuevo; riesgo R10 por cambios de reglas
    - Modelo de detección genérico (versión vigente de Ultralytics)
    Claude-Session: https://claude.ai/code/s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
    [bom.csv]
